chandansaipavanpadala/H.A.W.K-HumanActivityDetectionThroughWallsUsingMicrowaveKinetics/LTspice/HB100-ESP32.asc

C1: cap; 150µ
C2: cap; 0.047µ
C3: cap; 150µ
C4: cap; 0.047µ
R1: res; 10k
R2: res; 10k
R3: res; 10k
R4: res; 1Meg
R5: res; 10k
R6: res; 1Meg
U1: UniversalOpAmp2
U2: UniversalOpAmp2
V1: voltage; 5
V2: voltage; 5
V3: voltage; 3.3
V4: voltage; SINE(0 100u 0.3); AC 1
Named nets: 0, ESP32
.ac dec 100 0.01 10
.tran 10
