chandansaipavanpadala/H.A.W.K-HumanActivityDetectionThroughWallsUsingMicrowaveKinetics/ESP32/radar_sensor.h

#ifndef RADAR_SENSOR_H
#define RADAR_SENSOR_H

#include <Arduino.h>

// Function prototypes to expose them to ESP32.ino
void initRadar();
void vRadarAcquisitionTask(void *pvParameters);

#endif // RADAR_SENSOR_H
