chandansaipavanpadala/H.A.W.K-HumanActivityDetectionThroughWallsUsingMicrowaveKinetics/(commit log)

2026-04-14 Update esp32 folder
2026-06-16 Hybrid Calibration System
